olsoni/qwerky/ergogen/output/outlines/combo.dxf

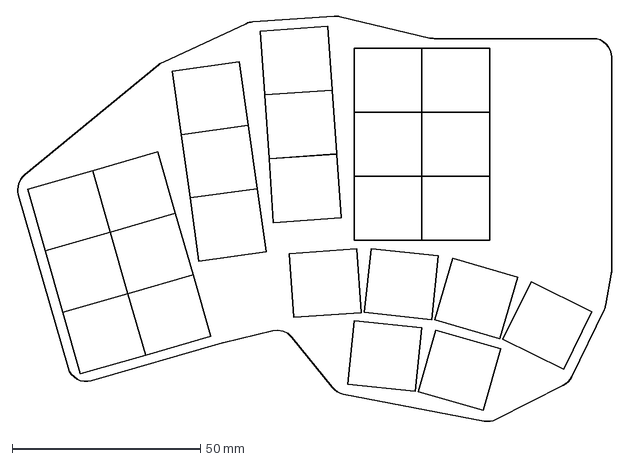
[picture p1: CAD file, 2026-02-27]
ergogen/output/outlines/combo.dxf
158.1 x 107.8 mm
