olsoni/qwerky/ergogen/output/outlines/board.dxf

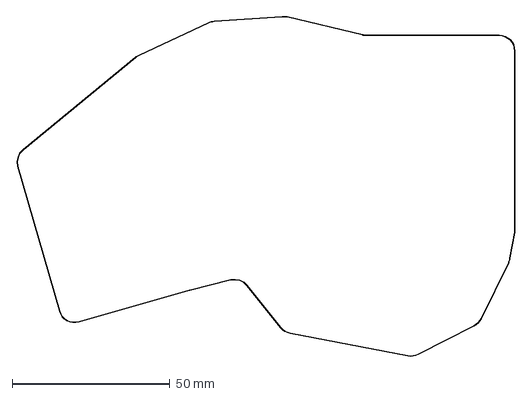
[picture p2: CAD file, 2026-02-27]
ergogen/output/outlines/board.dxf
158.1 x 107.8 mm
