olsoni/qwerky/ergogen/output/outlines/keys.dxf

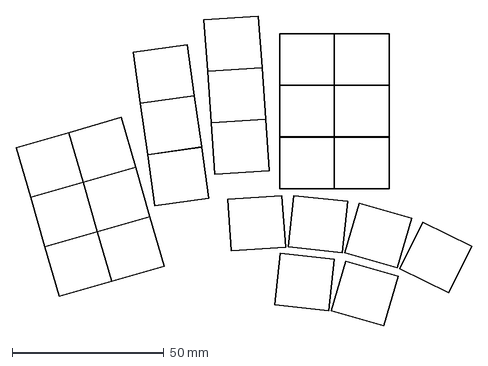
[picture p3: CAD file, 2026-02-27]
ergogen/output/outlines/keys.dxf
149.9 x 102.0 mm
