olsoni/qwerky/kicad/board.kicad_pcb

## KiCad design kicad/board.kicad_pcb (2026-03-12)

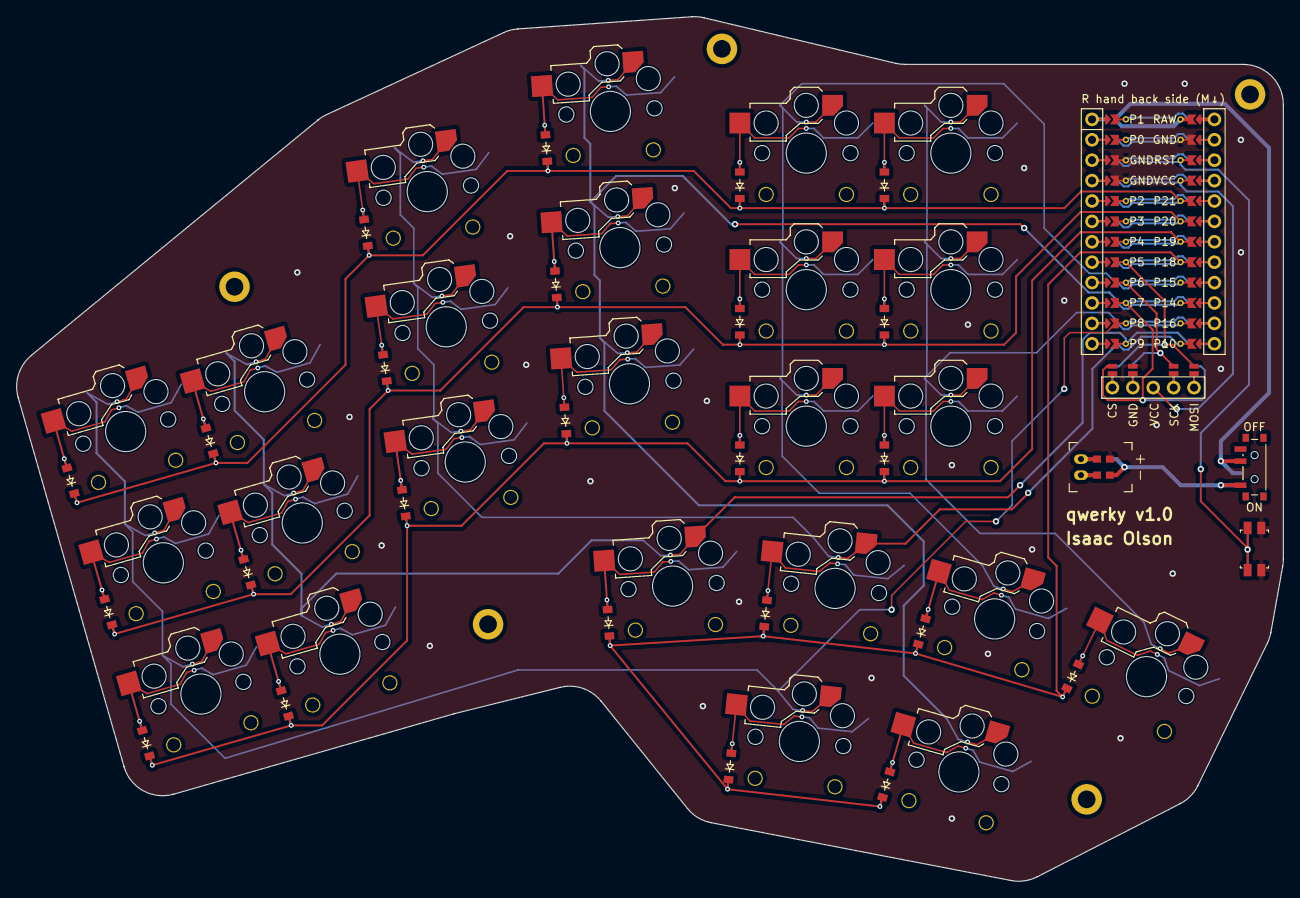
[picture p4: board board.kicad_pcb from above]

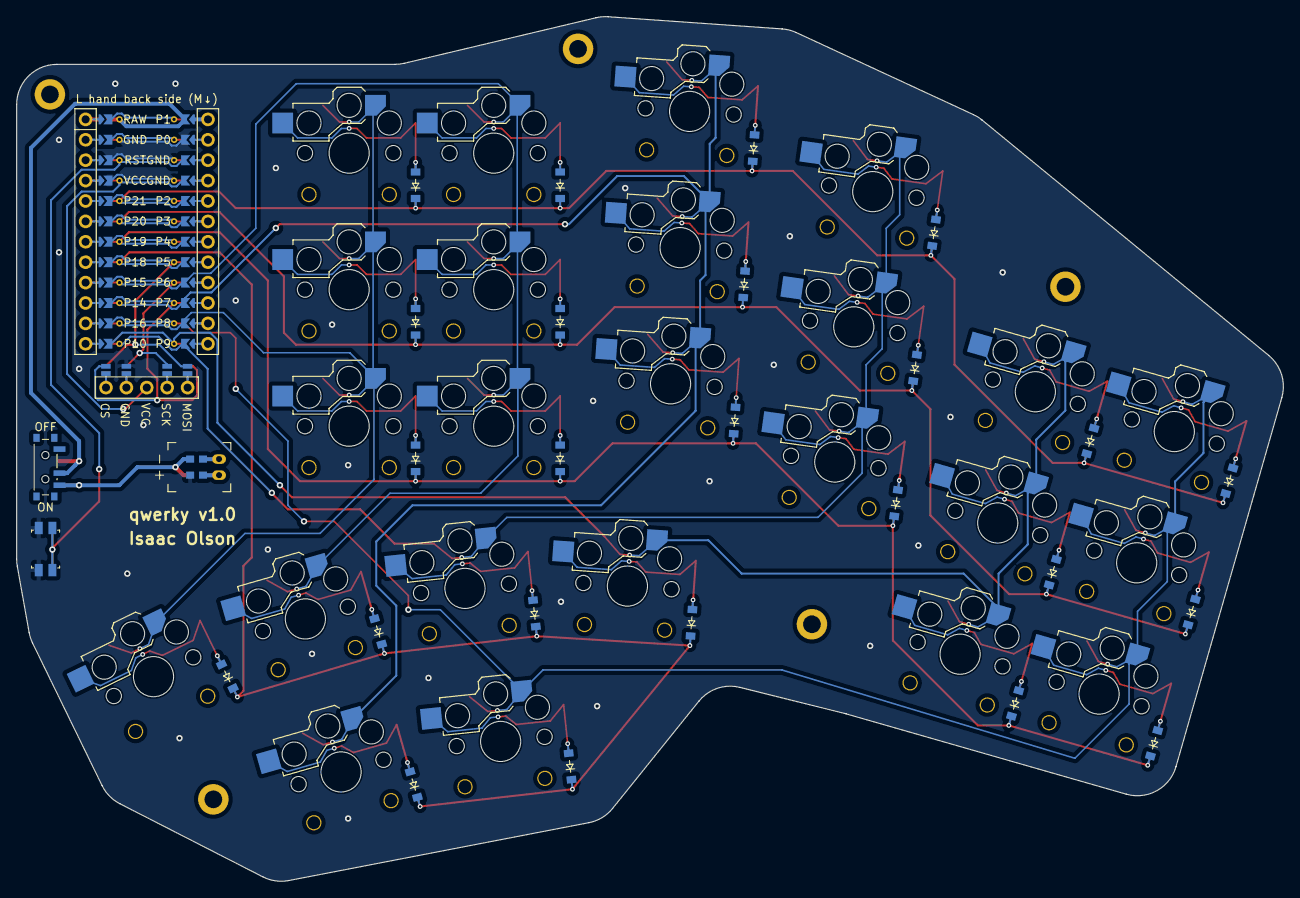
[picture p5: board board.kicad_pcb from below]

Board: 2 copper layers, 157.7 x 107.7 mm, 58 parts (24 on the bottom side), 48 nets.

Parts:
D1, D2, D3, D4, D5, D6, D7, D8, D9, D10, D11, D12, D13, D14, D15, D16, D17, D18, D19, D20, D21, D22, D23, D24: diode_tht_sod123
DISP1: display_nice_view
H1, H2, H3, H4, H5: mounting_hole_plated
JST1: battery_connector_jst_ph_2
MCU1: mcu_nice_nano
PWR1: power_switch_smd_side
RST1: reset_switch_smd_side
S1, S2, S3, S4, S5, S6, S7, S8, S9, S10, S11, S12, S13, S14, S15, S16, S17, S18, S19, S20, S21, S22, S23, S24: switch_choc_v1_v2

Connections:
BAT_P: JST1.1, PWR1.1, PWR1.3
CS: DISP1.14, DISP1.24, MCU1.115
DISP1_1: DISP1.1, DISP1.10, DISP1.23
DISP1_2: DISP1.2, DISP1.11, DISP1.22
DISP1_4: DISP1.4, DISP1.12, DISP1.21
DISP1_5: DISP1.5, DISP1.13, DISP1.20
GND: DISP1.15, DISP1.25, JST1.2, MCU1.102, MCU1.121, MCU1.122, RST1.1, RST1.3
JST1_1: JST1.11, JST1.21, JST1.31
JST1_2: JST1.12, JST1.22, JST1.32
MOSI: DISP1.17, DISP1.27, MCU1.117
P8: MCU1.114, S1.1, S2.1, S3.1, S23.1
P9: MCU1.113, S4.1, S5.1, S6.1, S19.1
P10: MCU1.112, S7.1, S8.1, S9.1, S20.1
P14: MCU1.110, S10.1, S11.1, S12.1, S24.1
P15: MCU1.109, S13.1, S14.1, S15.1, S21.1
P16: MCU1.111, S16.1, S17.1, S18.1, S22.1
P18: D19.1, D20.1, D21.1, D22.1, D23.1, D24.1, MCU1.108
P19: D1.1, D4.1, D7.1, D10.1, D13.1, D16.1, MCU1.107
P20: D2.1, D5.1, D8.1, D11.1, D14.1, D17.1, MCU1.106
P21: D3.1, D6.1, D9.1, D12.1, D15.1, D18.1, MCU1.105
RAW: MCU1.101, PWR1.2
RST: MCU1.103, RST1.2, RST1.4
SCK: DISP1.16, DISP1.26, MCU1.116
VCC: DISP1.3, MCU1.104
index_bottom: D13.2, S13.2
index_home: D14.2, S14.2
index_top: D15.2, S15.2
inner_bottom: D16.2, S16.2
inner_home: D17.2, S17.2
inner_top: D18.2, S18.2
middle_bottom: D10.2, S10.2
middle_home: D11.2, S11.2
middle_top: D12.2, S12.2
outer_bottom: D1.2, S1.2
outer_home: D2.2, S2.2
outer_top: D3.2, S3.2
pinky_bottom: D4.2, S4.2
pinky_home: D5.2, S5.2
pinky_top: D6.2, S6.2
ring_bottom: D7.2, S7.2
ring_home: D8.2, S8.2
ring_top: D9.2, S9.2
tb_inner_tb_bot: D24.2, S24.2
tb_outer_tb_bot: D23.2, S23.2
tt_home_tt_top: D21.2, S21.2
tt_inner_tt_top: D22.2, S22.2
tt_middle_tt_top: D20.2, S20.2
tt_outer_tt_top: D19.2, S19.2
