olsoni/qwerky/(commit log)

2026-01-25 working our way up
    [board.kicad_pcb]
2026-01-25 more footprints
2026-01-28 pretty sure the micro controller B.silk layer is wrong
    [board.kicad_pcb]
2026-02-14 kicad file for reversed labels
    [board.kicad_pcb]
2026-02-14 pin net syntax
2026-02-14 picked pins for the matrix
    [board.kicad_pcb]
2026-02-16 adding switches and battery connector
    [board.kicad_pcb]
2026-02-16 mounting holes
    [board.kicad_pcb]
2026-02-16 connected display pins
    [board.kicad_pcb]
2026-02-16 using better footprint for key switches
    [board.kicad_pcb]
2026-02-16 hmmm, have to debug this footprint
    [board.kicad_pcb]
2026-02-16 ok looking good
    [board.kicad_pcb]
2026-02-16 well codex didn't actually quite fix the arcs right so I made them lines
    [board.kicad_pcb]
2026-02-19 ready to route
    [board.kicad_pcb]
2026-02-19 realizing I'm going to want to change some of the layout
    [board.kicad_pcb]
2026-02-19 rebased and pulled in new footprints
    [board.kicad_pcb]
2026-02-19 routing coming along nicely
    [board.kicad_pcb]
2026-02-19 just need to zone fill
    [board.kicad_pcb]
2026-02-20 added a ground plane
    [board.kicad_pcb]
2026-02-20 random other kicad files ...
2026-02-20 making layout changes for easier routing
    [board.kicad_pcb]
2026-02-20 coming along quite well
    [board.kicad_pcb]
2026-02-21 maybe done?
    [board.kicad_pcb]
2026-02-23 things to consider:
    - add inline fuse for battery
    - lots of vias in the ground planes
    - don't bother doing ground traces
    - get the design rules off JLPCP and then put them in kicad
    - make the main power trace a bit wider (3 mm)
    [board.kicad_pcb]
2026-02-24 configuring for local ergogen run
    [board.dxf, board.kicad_pcb, combo.dxf, keys.dxf]
2026-02-24 improving routing
    [board.kicad_pcb]
2026-02-27 pretty sweet
    [board.kicad_pcb]
2026-02-27 moved the keys around as desired
    [board.dxf, board.kicad_pcb, combo.dxf, keys.dxf]
2026-02-27 moved components
    [board.kicad_pcb]
2026-02-27 slightly larger vias for batt conn
    [board.kicad_pcb]
2026-02-28 starting routing
    [v1.kicad_pcb, v2.kicad_pcb]
2026-02-28 looking pretty good so far
    [v2.kicad_pcb]
2026-02-28 on to DRC
    [v2.kicad_pcb]
2026-02-28 removing old version
    [board.kicad_pcb, v1.kicad_pcb]
2026-02-28 fixing trace width for raw on nicenano footprint
    [board.kicad_pcb]
2026-03-12 generated gerbers
    [board-B_Cu.gbr, board-B_Mask.gbr, board-B_Paste.gbr, board-B_Silkscreen.gbr, board-Edge_Cuts.gbr, board-F_Cu.gbr, board-F_Mask.gbr, board-F_Paste.gbr]
2026-05-02 starting on bom
